zahrada/2018-thesis-drone/README.md

Construction of unmanned uerial vehicle for surveying jobs
 Department of Geomatics, FCE CTU in Prague, Czech Republic
