zahrada/2018-thesis-drone/text/1-reserse.tex

\chapter{Rešerše}
\label{1-reserse}

Bezpilotní letadla/drony jsou fenoménem dnešního stolení, zabývá se jimi spousta článku a projektů. Jsou zde uvedené projekty, které se zabývají stavbou dronu na platformě Arduino.\\

\textbf{Projekt YMFC-32}\\
%http://www.brokking.net/
%ymfc
Projekt popisuje stavbu dronu/quadrocoptéry ovládaného přes RC soupravu. Pro ovládání motorů na dronu byla použita platforma Arduino a periferie Arduina (IMU, Bluetooth).\\

\textbf{Univerzální software pro ovládání RC model;}\\
%http://www.multiwii.com/
%multiwii
Software je používán pro stavbu drona na platformě Arduino. Software obsahuje předdefinované různé typy dronů a Arduino periferíí.\\

\textbf{Projekt Arduino quadrocopter}\\
%http://mydronelab.com/blog/arduino-quadcopter.html
%mydronelab
Projekt se zabývá stavbou quadrokoptéry na platformě Arduino s využitím softwaru  Multiwii.\\

%https://www.geobusiness.cz/soutez-dronapp-2018/
