zahrada/2018-thesis-drone/diagrams/text/2-reserse.tex

\chapter{Rešerše}
\label{2-teorie}

Bezpilotní letadla/drony jsou fenoménem dnešní doby a zabývá se jimi spousta článků a projektů. Jsou zde uvedené projekty, které se zabývají stavbou dronu na platformě Arduino.\\

\textbf{Projekt YMFC-32}\\
%http://www.brokking.net/
Projekt popisuje stavbu dronu/quadrocoptéry ovládaného přes RC soupravu. Pro ovládání motorů na dronu byla použita platforma Arduino a periferie Arduina (IMU, Bluetooth). \cite{ymfc}\\

\textbf{Univerzální software pro ovládání RC modelů;}\\
%http://www.multiwii.com/
Software je používán pro stavbu drona na platformě Arduino. Software obsahuje předdefinované různé typy dronů a Arduino periferíí. \cite{multiwii}\\

\textbf{Projekt Arduino quadrocopter}\\
%http://mydronelab.com/blog/arduino-quadcopter.html
Projekt se zabývá stavbou quadrokoptéry na platformě Arduino s využitím softwaru  Multiwii. \cite{mydronelab}\\

%https://www.geobusiness.cz/soutez-dronapp-2018/
