zahrada/2018-thesis-drone/text/pictures/PWMDiagram.pdf

5V

0V

Signal

0uS

1000uS

2000uS

3000uS
4000uS

Time

HIGH

LOW

### PWM signal for ESC

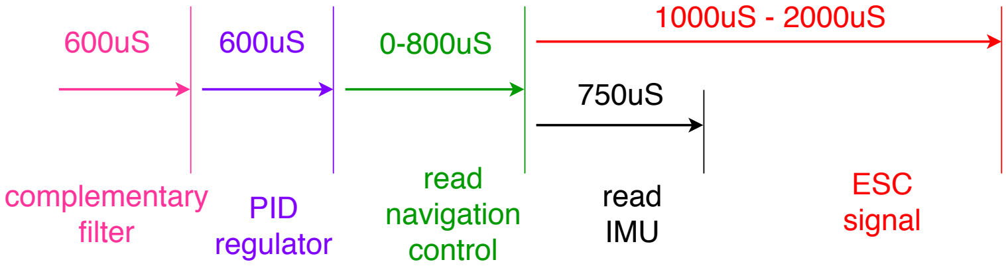
[picture p22: figure]
complementary filter; read navigation control; PID regulator; read IMU; ESC signal

Author: David Zahradník

frequency - 250Hz
