zahrada/2018-thesis-drone/diagrams/text/david-zahradnik-dp-2019.tex

%%%%%%%%%%%%%%%%%%%%%%%%%%%%%%%%%%%%%%%%%%%%%%%%%%%%%%%%%%%%%%%%%%%%%%%%%%%%%%%%%%%%%%%%%%%%%%%%%%%%%%%
%%													%%
%% 	DIPLOMOVÁ PRÁ			%%
%% 				 David Zahradník							%%
%%													%%
%% pro formátování využita šablona: http://geo3.fsv.cvut.cz/kurzy/mod/resource/view.php?id=775 	%%
%%													%%
%%%%%%%%%%%%%%%%%%%%%%%%%%%%%%%%%%%%%%%%%%%%%%%%%%%%%%%%%%%%%%%%%%%%%%%%%%%%%%%%%%%%%%%%%%%%%%%%%%%%%%% 

\documentclass[%
  12pt,         			% Velikost základního písma je 12 bodů
  a4paper,      			% Formát papíru je A4
  oneside,       			% Oboustranný tisk
  pdftex,				    % překlad bude proveden programem 'pdftex' do PDF
%%%  draft
]{report}       			% Dokument třídy 'zpráva'
%

\newcommand{\Fbox}[1]{\fbox{\strut#1}}

\usepackage[czech, english]{babel}	% použití češtiny, angličtiny
\usepackage[utf8]{inputenc}		% Kódování zdrojových souborů je UTF8

\usepackage[square,sort,comma,numbers]{natbib}

\usepackage{caption}
\usepackage{subcaption}
\captionsetup{font=small}
\usepackage{enumitem} 
\setlist{leftmargin=*} % bez odsazení

\makeatletter
\setlength{\@fptop}{0pt}
\setlength{\@fpbot}{0pt plus 1fil}
\makeatletter

\usepackage[dvips]{graphicx}   
\usepackage{color}
\usepackage{transparent}
\usepackage{wrapfig}
\usepackage{float} 

\usepackage{cmap}           
\usepackage[T1]{fontenc}    

\usepackage{textcomp}
\usepackage[compact]{titlesec}
\usepackage{amsmath}
\addtolength{\jot}{1em} 

\usepackage{chngcntr}
\counterwithout{footnote}{chapter}

\usepackage{acronym}

\usepackage[
    unicode,                
    breaklinks=true,        
    hypertexnames=false,
    colorlinks=true, % true for print version
    citecolor=black,
    filecolor=black,
    linkcolor=black,
    urlcolor=black
]{hyperref}         

\usepackage{url}
\usepackage{fancyhdr}
%\usepackage{algorithmic}
\usepackage{algorithm}
\usepackage{algcompatible}
\renewcommand{\ALG@name}{Pseudokód}% Update algorithm name
\def\ALG@name{Pseudokód}

\usepackage[
  cvutstyle,          
  diploma           
]{thesiscvut}

\newif\ifweb
\ifx\ifHtml\undefined % Mimo HTML.
    \webfalse
\else % V HTML.
    \webtrue
\fi 

\renewcommand{\figurename}{Obrázek}
\def\figurename{Obrázek}

%%%%%%%%%%%%%%%%%%%%%%%%%%%%%%%%%%%%%%%%%%%%%%%%%%%%%%%%%%%%%%%%%
%%%%%%%%%%% Definice informací o dokumentu  %%%%%%%%%%%%%%%%%%%%%
%%%%%%%%%%%%%%%%%%%%%%%%%%%%%%%%%%%%%%%%%%%%%%%%%%%%%%%%%%%%%%%%%

%% Název práce
\nazev{Konstrukce bezpilotního letadla pro \hyphenation{geodetické} práce}
{sdgfdg}

%% Jméno a příjmení autora
\autor{David}{Zahradník}

%% Jméno a příjmení vedoucího práce včetně titulů
\garant{Ing.~Zdeněk~Vyskočil,~Ph.D.}

%% Označení programu studia
\programstudia{Geodézie a~kartografie}{}

%% Označení oboru studia
\oborstudia{Geomatika}{}

%% Označení ústavu
\ustav{Katedra geomatiky}{}

%% Rok obhajoby
\rok{2019}

%Mesic obhajoby
\mesic{červen}

%% Místo obhajoby
\misto{Praha}

%% Abstrakt
\abstrakt {Tato diplomová práce se zabývá konstrukcí bezpilotního letadla pro geodetické účely na platformě Arduino s Arduino periferiemi.}  {This thesis describes construction of unmanned aerial vehicle for surveying jobs using Arduino platform and Arduino moduls.}

%% Klíčová slova
\klicovaslova
{bezpilotní letadlo, dron, Arduino, Android}
{UAV, dron, Arduino, Android}

%%%%%%%%%%%%%%%%%%%%%%%%%%%%%%%%%%%%%%%%%%%%%%%%%%%%%%%%%%%%%%%%%%%%%%%%

%%%%%%%%%%%%%%%%%%%%%%%%%%%%%%%%%%%%%%%%%%%%%%%%%%%%%%%%%%%%%%%%%%%%%%%%
%% Nastavení polí ve Vlastnostech dokumentu PDF
%%%%%%%%%%%%%%%%%%%%%%%%%%%%%%%%%%%%%%%%%%%%%%%%%%%%%%%%%%%%%%%%%%%%%%%%
\nastavenipdf
%%%%%%%%%%%%%%%%%%%%%%%%%%%%%%%%%%%%%%%%%%%%%%%%%%%%%%%%%%%%%%%%%%%%%%%

%%% Začátek dokumentu
\begin{document}

\catcode`\-=12  % pro vypnuti aktivniho znaku '-' pouzivaneho napr. v \cline 

% aktivace záhlaví
\zahlavi

% předefinování vzhledu záhlaví
\renewcommand{\chaptermark}[1]{%
	\markboth{\MakeUppercase
	{%
	\thechapter.%
	\ #1}}{}}

% Vysázení přebalu práce
%\vytvorobalku

% Vysázení titulní stránky práce
\vytvortitulku {}

% Vysázení listu zadani
\stranka{}%
	{
	}%\sffamily\Huge\centering\ }%ZDE VLOŽIT LIST ZADÁNÍ}%
	%{\sffamily\centering Z~důvodu správného číslování stránek}

% Vysázení stránky s abstraktem
\vytvorabstrakt

% Vysázení prohlaseni o samostatnosti
\vytvorprohlaseni

% Vysázení poděkování
\stranka{%nahore
       }{%uprostred
       }{%dole
       \sffamily
	\begin{flushleft}
		\large
		\MakeUppercase{Poděkování}
	\end{flushleft}
	\vspace{1em}
		%\noindent
	\par\hspace{2ex}
	{Chtěl bych poděkovat Ing. Zdeňkovi Vyskočilovi Ph.D. za pomoc a rady při zpracování diplomové práce. Dále bych rád poděkoval Lukášovi Černému za poskytnuté rady a vysvětlení témat týkajících se elektrotechniky.}
}

% Vysázení obsahu
\obsah

% Vysázení seznamu obrázků
\seznamobrazku

% Vysázení seznamu tabulek
\seznamtabulek

% jednotlivé kapitoly
\include{0-uvod}
\include{2-reserse}
\include{2-teorie}
\include{3-soucastky}
%\include{4-stavba}
\include{5-algoritmus}
\include{6-testovani}
\include{7-aplikace}
\include{8-zaver}

% Vysázení seznamu zkratek
\include{zkratky}

% Literatura
\nocite{*}
\def\refname{Literatura}
\bibliographystyle{mystyle}
\bibliography{literatura}

% Začátek příloh
\def\figurename{Figure}%
\prilohy

% Vysázení seznamu příloh
%\seznampriloh

% Vložení souboru s přílohami
\include{prilohy}

% Konec dokumentu
\end{document}
