zahrada/2018-thesis-drone/text/pictures/navictrl.pdf

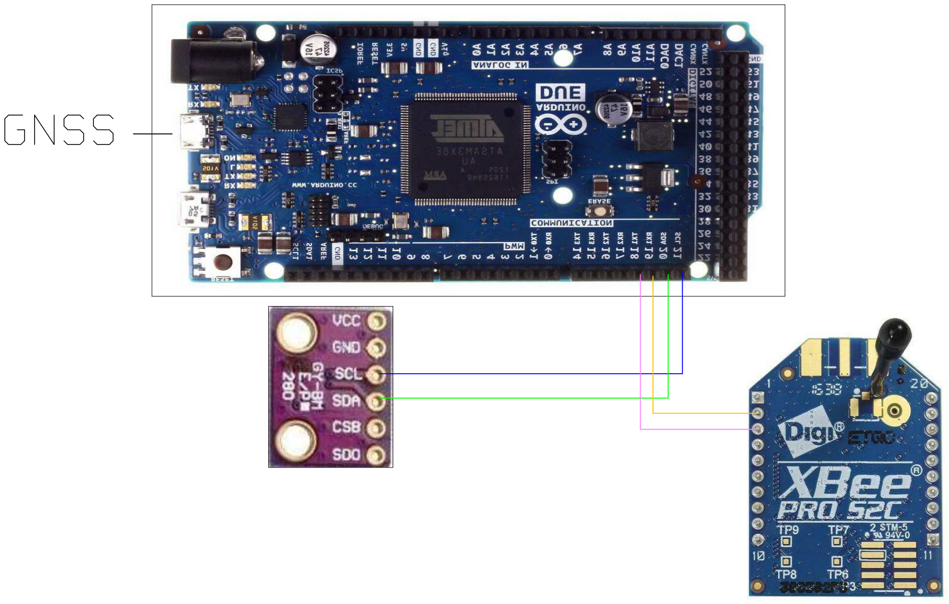
[picture p23: page 1]
