zahrada/2018-thesis-drone/diagrams/text/pictures/flyctrl.pdf

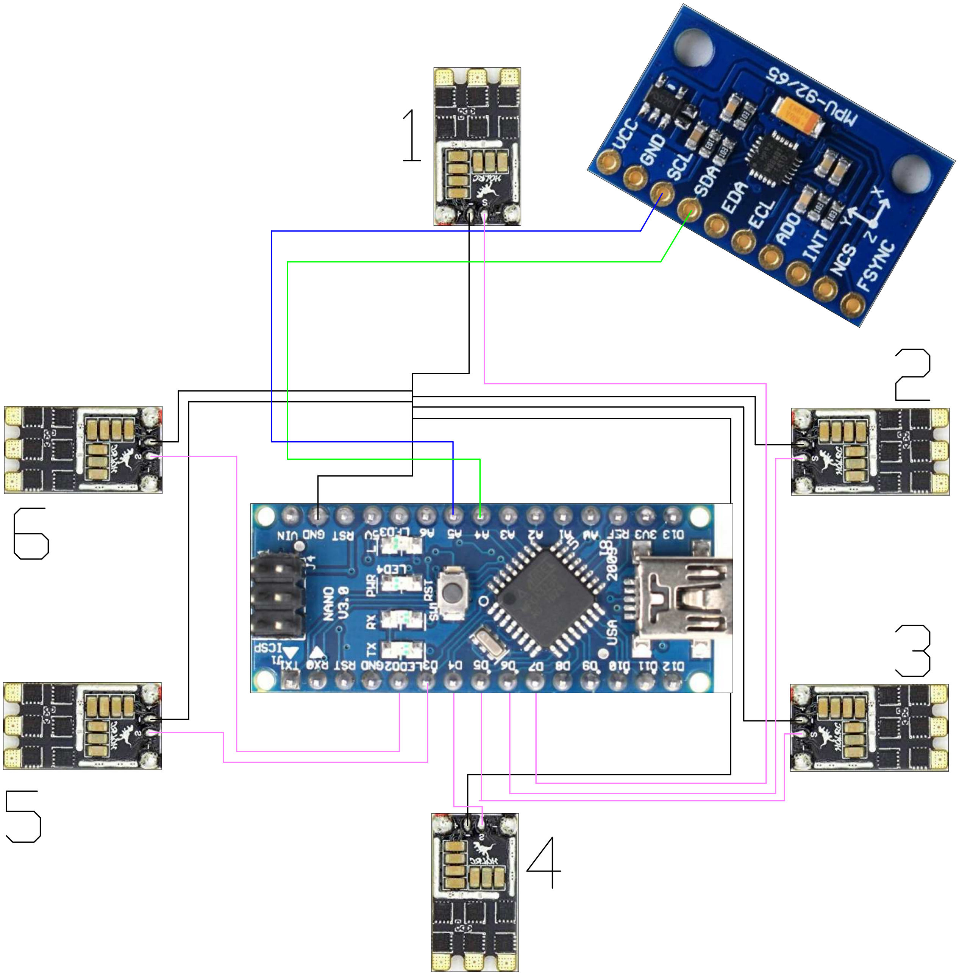
[picture p24: figure]
