zahrada/2018-thesis-drone/diagrams/text/pictures/obstacle.pdf

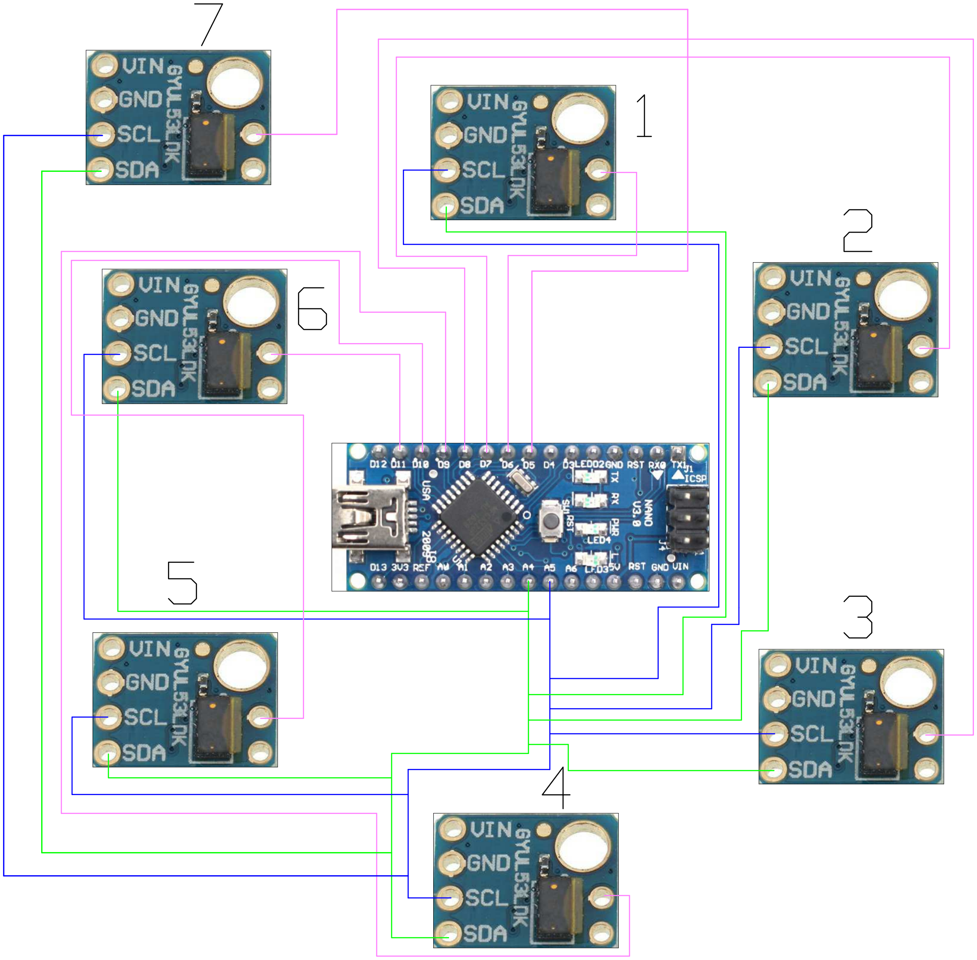
[picture p25: figure]
