zahrada/2018-thesis-drone/diagrams/text/pictures/pdb_ardu.pdf

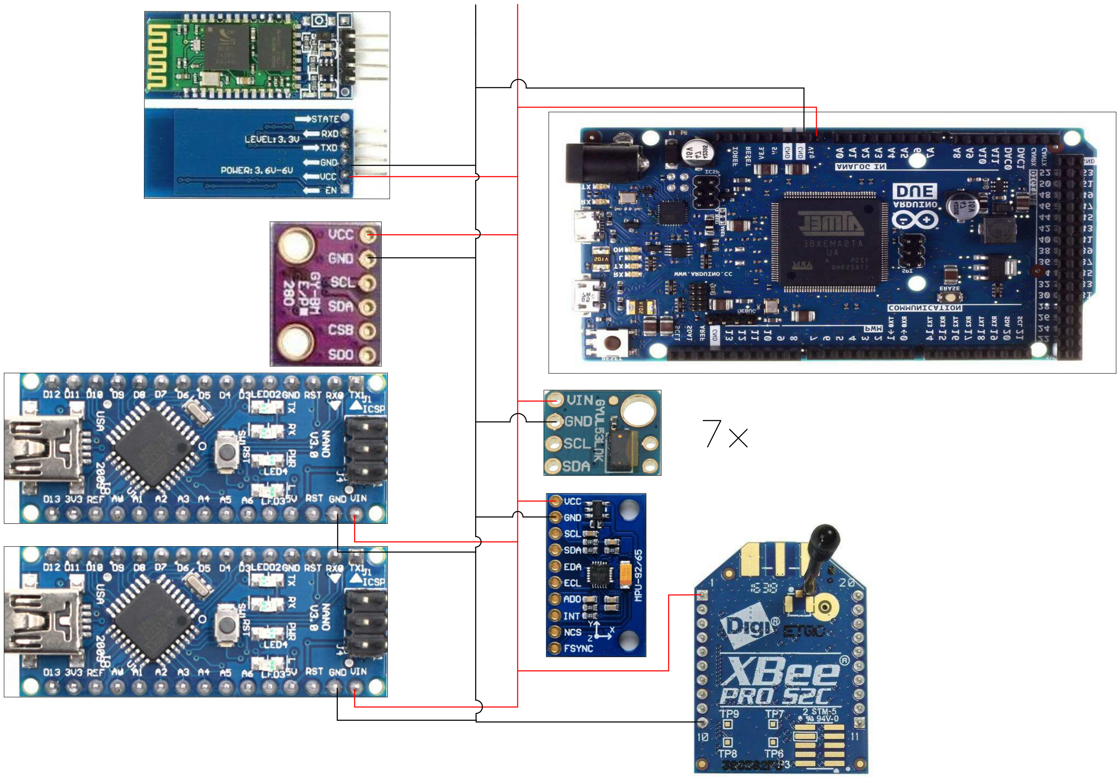
[picture p26: page 1]
