zahrada/2018-thesis-drone/diagrams/text/pictures/zadani.pdf

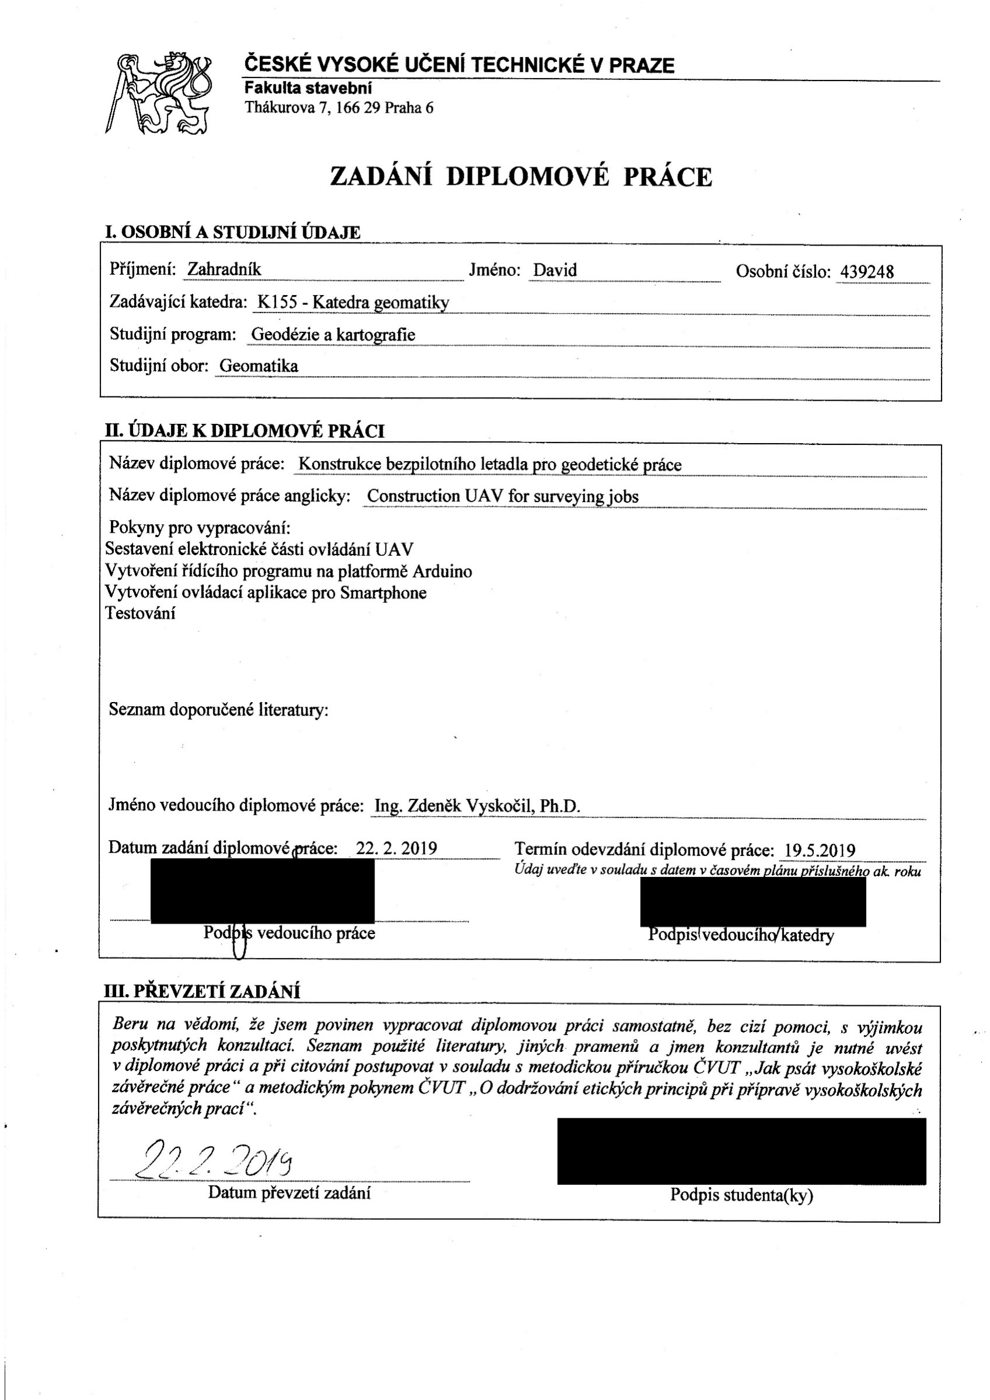
[picture p27: page 1]
