zahrada/2018-thesis-drone/diagrams/text/pictures/esc_calib.pdf

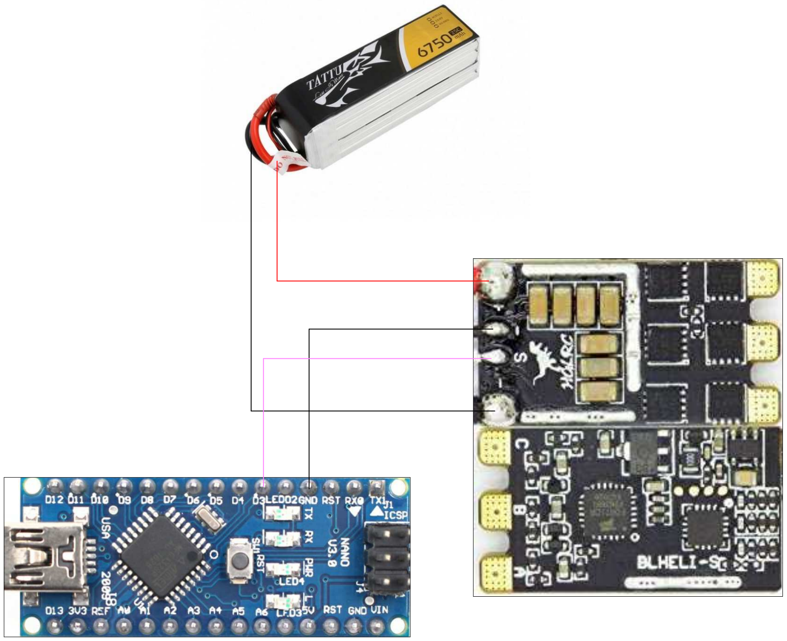
[picture p28: page 1]
