zahrada/2018-thesis-drone/diagrams/text/pictures/motor.pdf

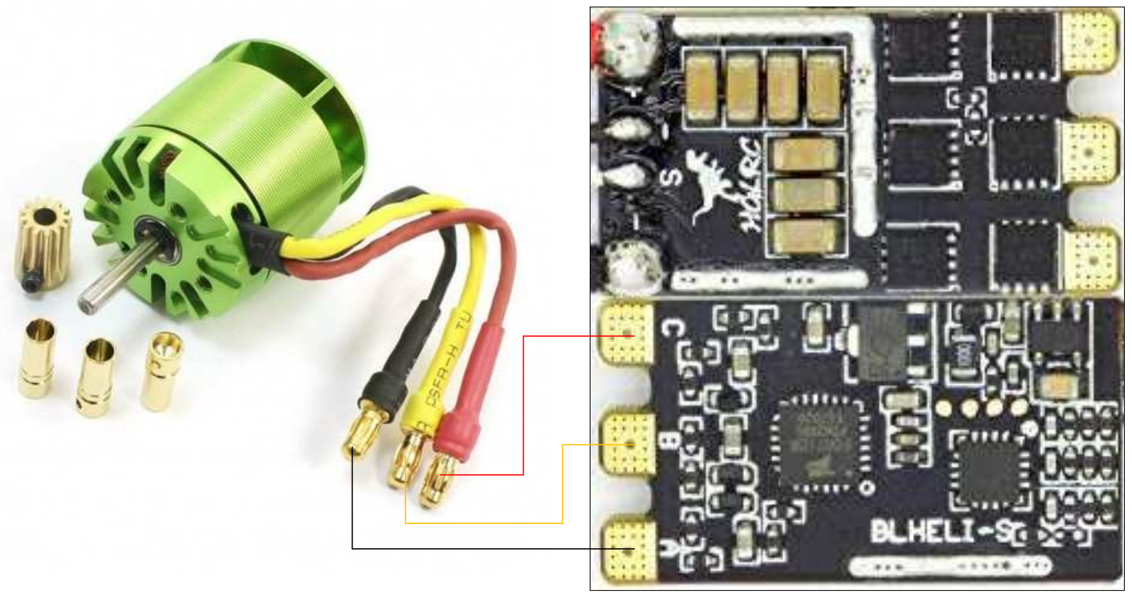
[picture p29: page 1]
