zahrada/2018-thesis-drone/diagrams/text/pictures/esc_calib1.jpg

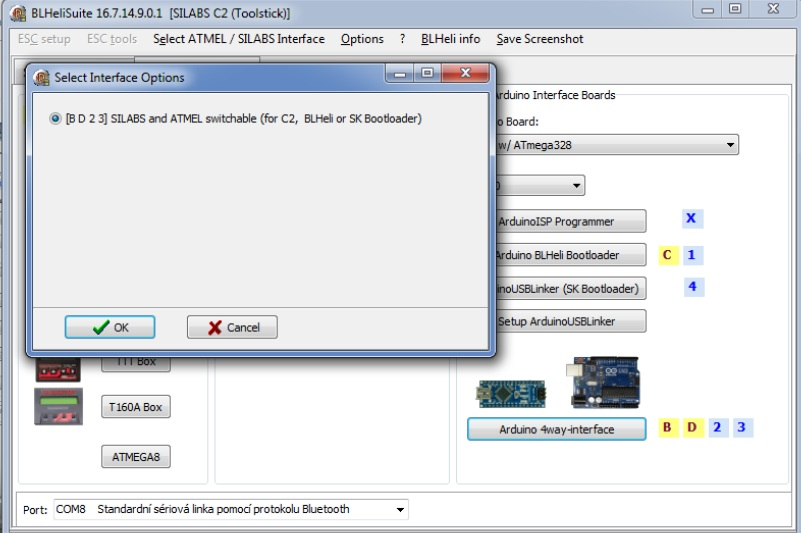
diagrams/text/pictures/esc_calib1.jpg
