zahrada/2018-thesis-drone/diagrams/text/pictures/esc_calib3.jpg

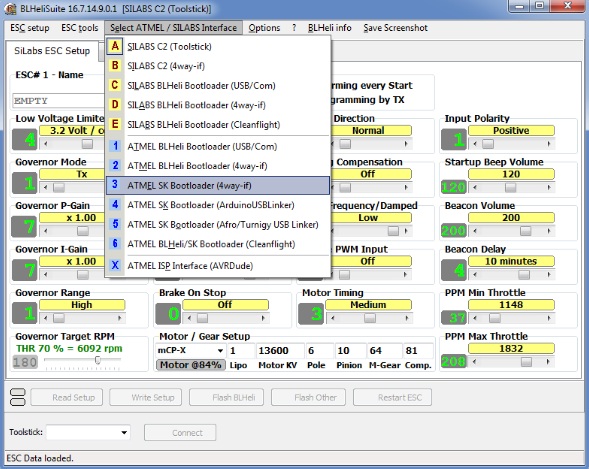
diagrams/text/pictures/esc_calib3.jpg
