zahrada/2018-thesis-drone/diagrams/text/pictures/zadani.jpg

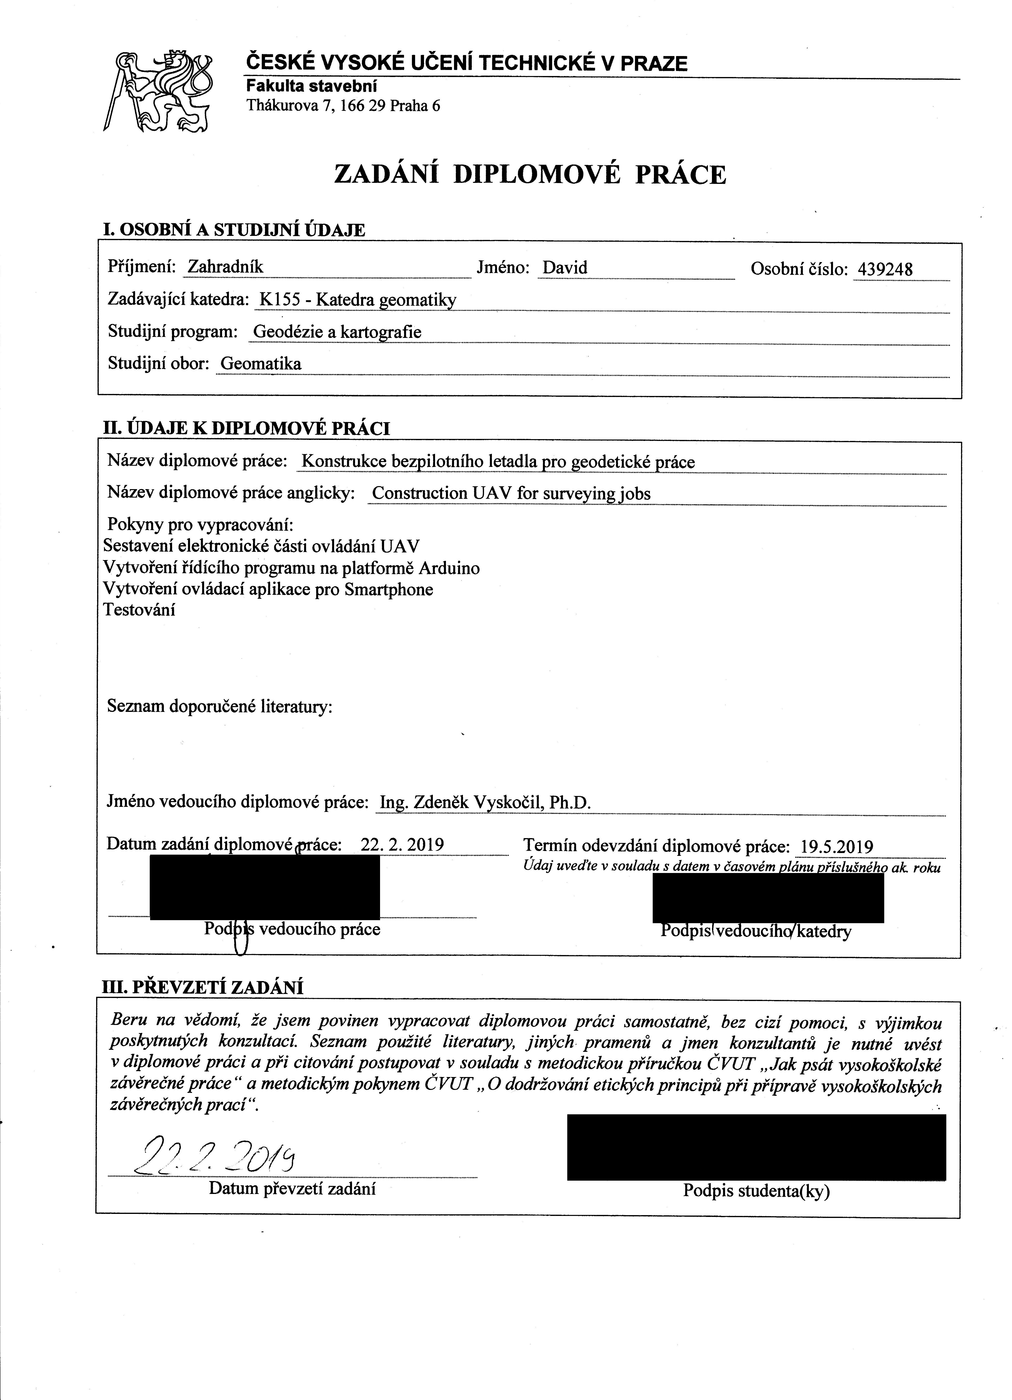
diagrams/text/pictures/zadani.jpg
