zahrada/2018-thesis-drone/testingIMU/results.txt

eps = 0.00000001;

data_2018_11_16_9_07.m
Start from 2260
Heading is 113.186980 0.433416
Pitch is -0.729511 0.014578
Roll is 0.638921 0.003028
North is 311.623718 46.927729
>> 

data_2018_11_16_9_26.m
Start from 2267
Heading is 112.851388 0.051998
Pitch is -0.667009 0.013853
Roll is 0.688009 0.002768
North is 316.273513 47.825867
>> 

data_2018_11_16_9_44.m
Start from 1574
Heading is 113.821797 0.158678
Pitch is -0.819365 0.014549
Roll is 0.665427 0.003013
North is 309.473818 40.155538

data_2018_11_16_9_54.m
Start from 1290
Heading is 114.127414 0.730425
Pitch is -0.806325 0.020755
Roll is 0.650201 0.003610
North is 309.518649 55.124147
>> 

data_2018_11_16_10_15.m
Start from 1406
Heading is 113.195257 0.356729
Pitch is -0.738615 0.015786
Roll is 0.705472 0.003096
North is 314.087512 47.828897
>> 

eps = 0.0000000001;

data_2018_11_16_10_15.m
Start from 2815
Heading is 112.995883 0.039574
Pitch is -0.716273 0.012963
Roll is 0.713163 0.002643
North is 315.215289 41.817757
