zahrada/2018-thesis-drone/diagrams/text/pictures/testAGC.png

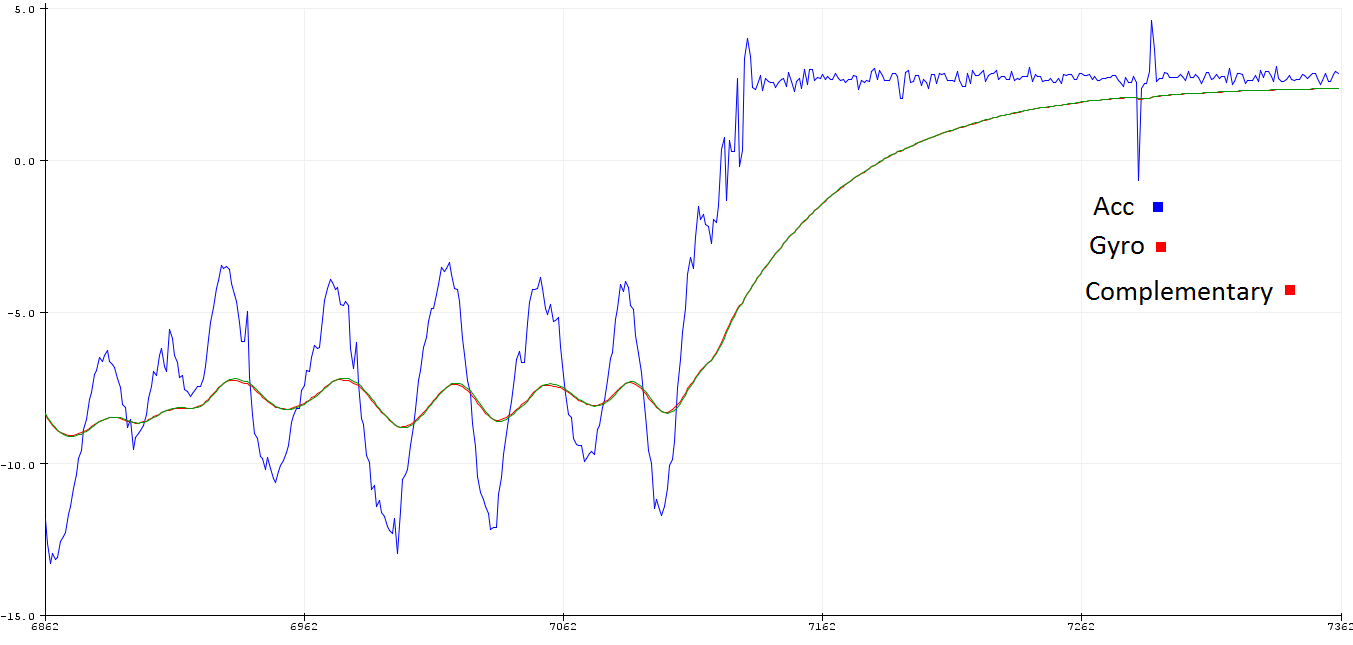
diagrams/text/pictures/testAGC.png
