zahrada/2018-thesis-drone/diagrams/text/pictures/testGMC.png

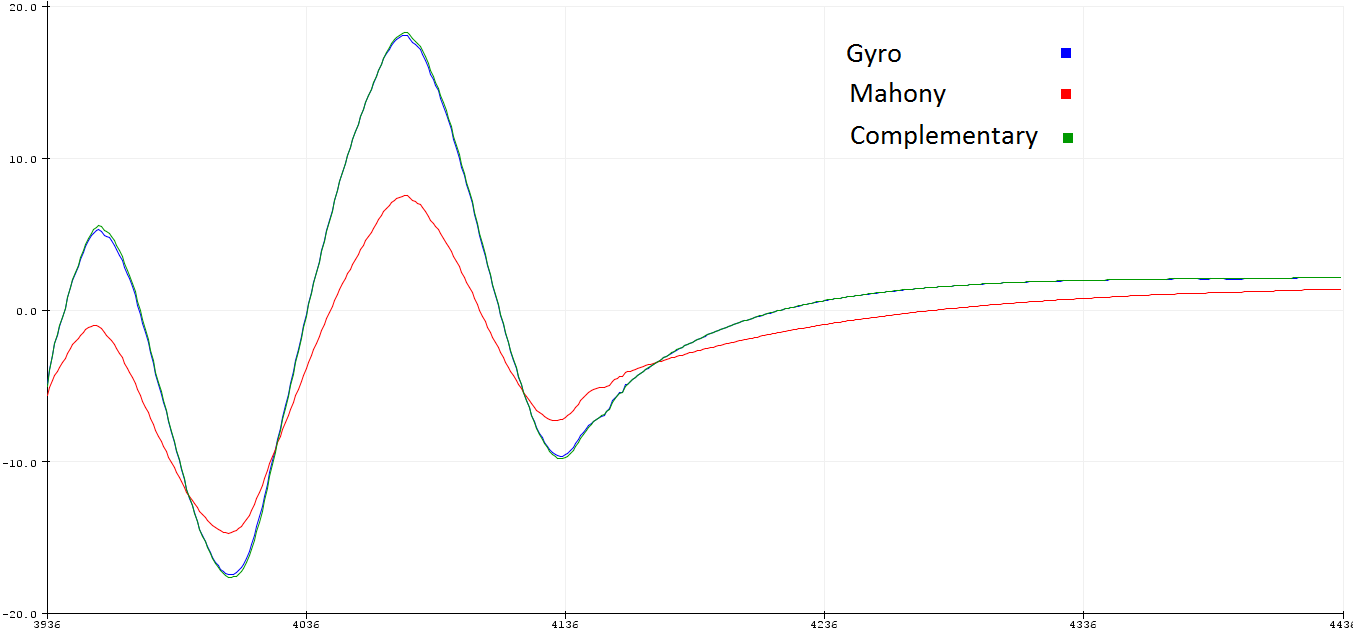
diagrams/text/pictures/testGMC.png
