zahrada/2018-thesis-drone/diagrams/text/pictures/testIMUACC.png

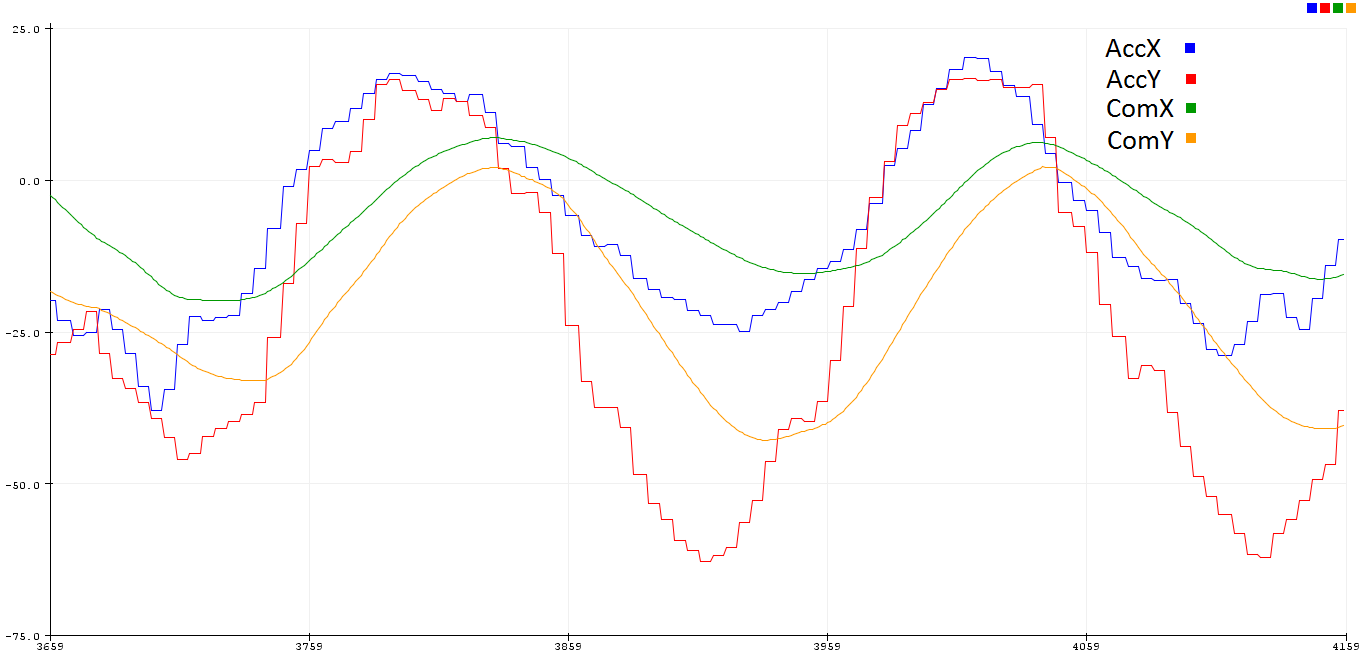
diagrams/text/pictures/testIMUACC.png
