zahrada/2018-thesis-drone/testingIMU/graf.tif

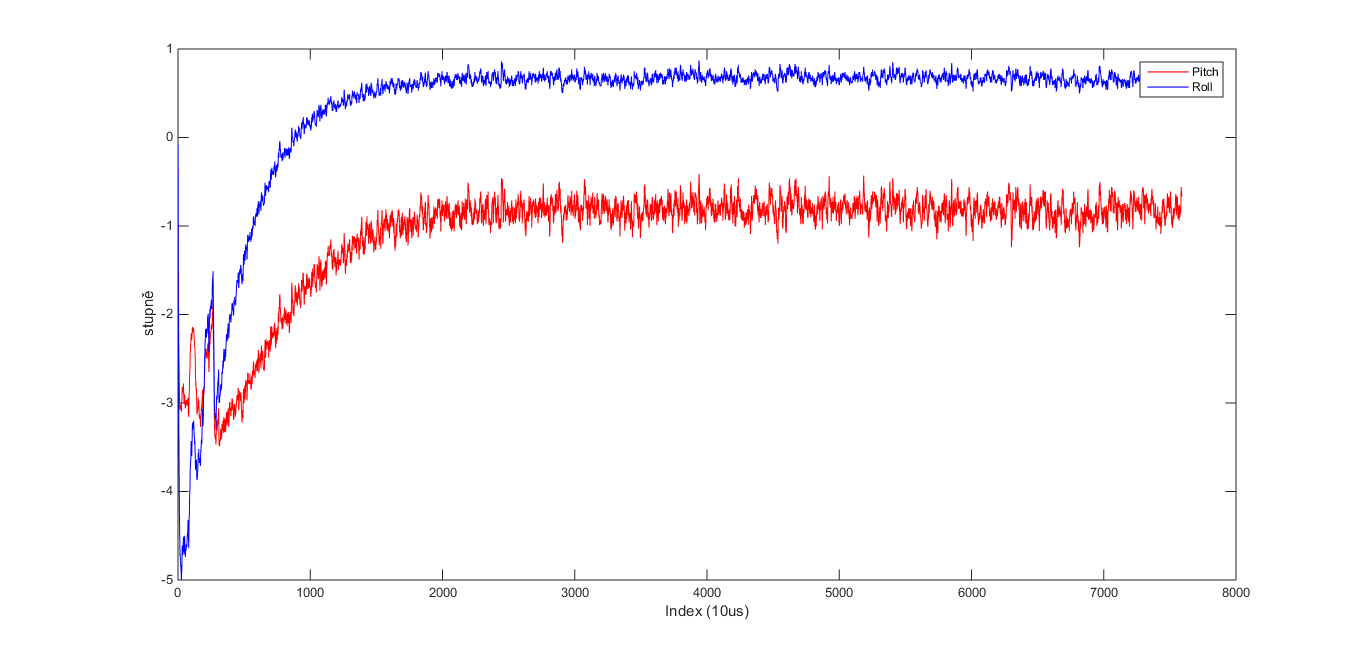
testingIMU/graf.tif
