zahrada/2018-thesis-drone/diagrams/text/pictures/DroneDiagram.pdf

## Diagram of connection

## Controler

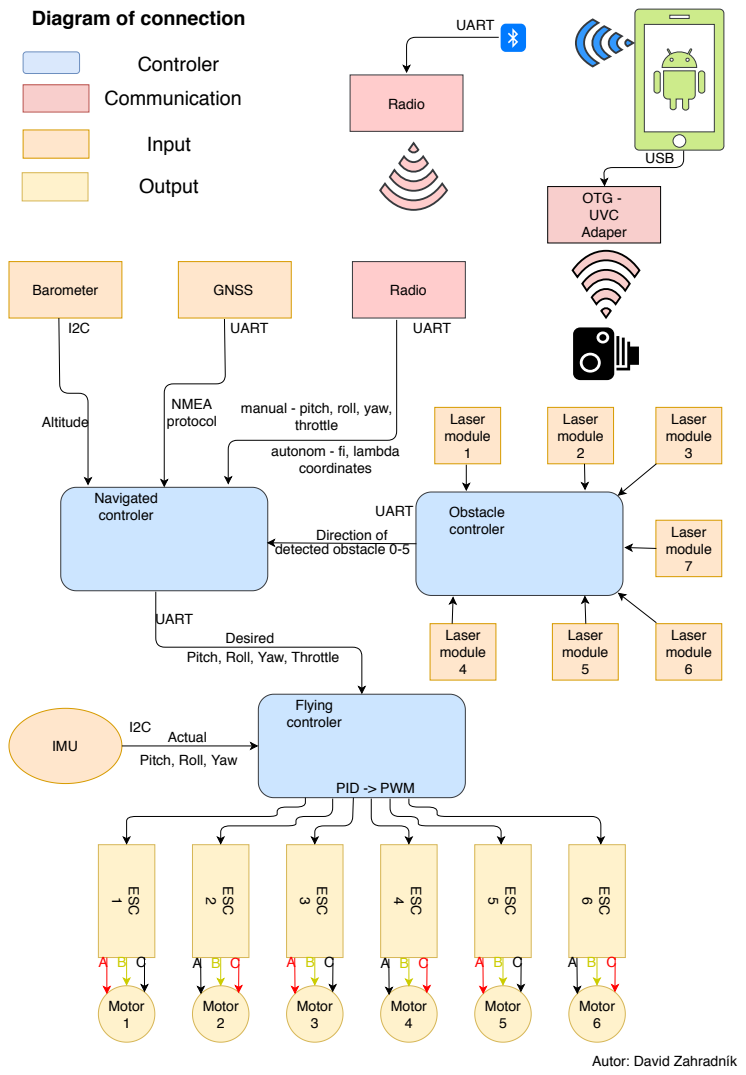
[picture p42: page 1]
Navigated controler; Motor 1; Motor 2; Motor 3; Motor 4; Motor 5; Motor 6; ESC; PID -> PWM; IMU; Pitch, Roll, Yaw; Actual; Flying controler; Obstacle controler; Laser module 5; Laser module 1; Laser module 2; Laser module 3; Laser module 7; Laser module 6; Laser module 4; UART; Direction of detected obstacle 0-5; Barometer; GNSS; Radio; Altitude; NMEA protocol; OTG - UVC Adaper; USB; Communication; Input; Output

manual - pitch, roll, yaw,

throttle
autonom - fi, lambda
coordinates

Desired
Pitch, Roll, Yaw, Throttle

Autor: David Zahradník
