zahrada/2018-thesis-drone/diagrams/text/pictures/FlyingDiagram.pdf

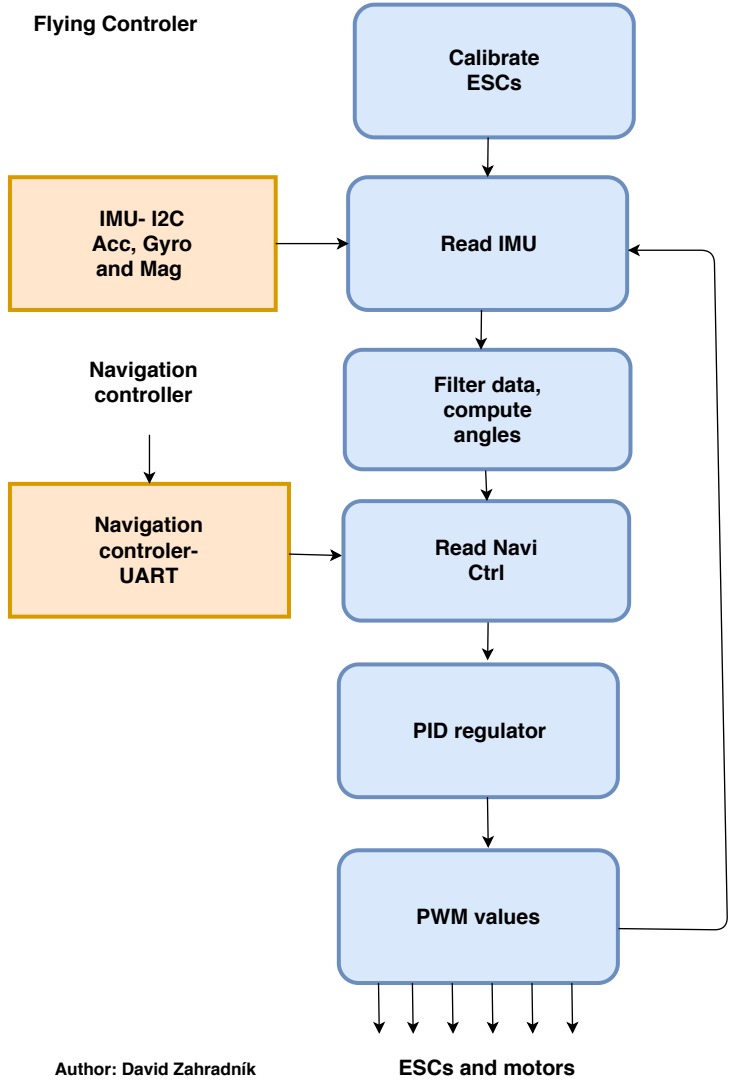
[picture p43: page 1]
Flying Controler; Navigation controler- UART; IMU- I2C Acc, Gyro and Mag; Read IMU; Filter data, compute angles; PID regulator; PWM values; Calibrate ESCs; Read Navi Ctrl; Navigation controller

Author: David Zahradník

ESCs and motors
