zahrada/2018-thesis-drone/diagrams/text/pictures/NaviDiagram.pdf

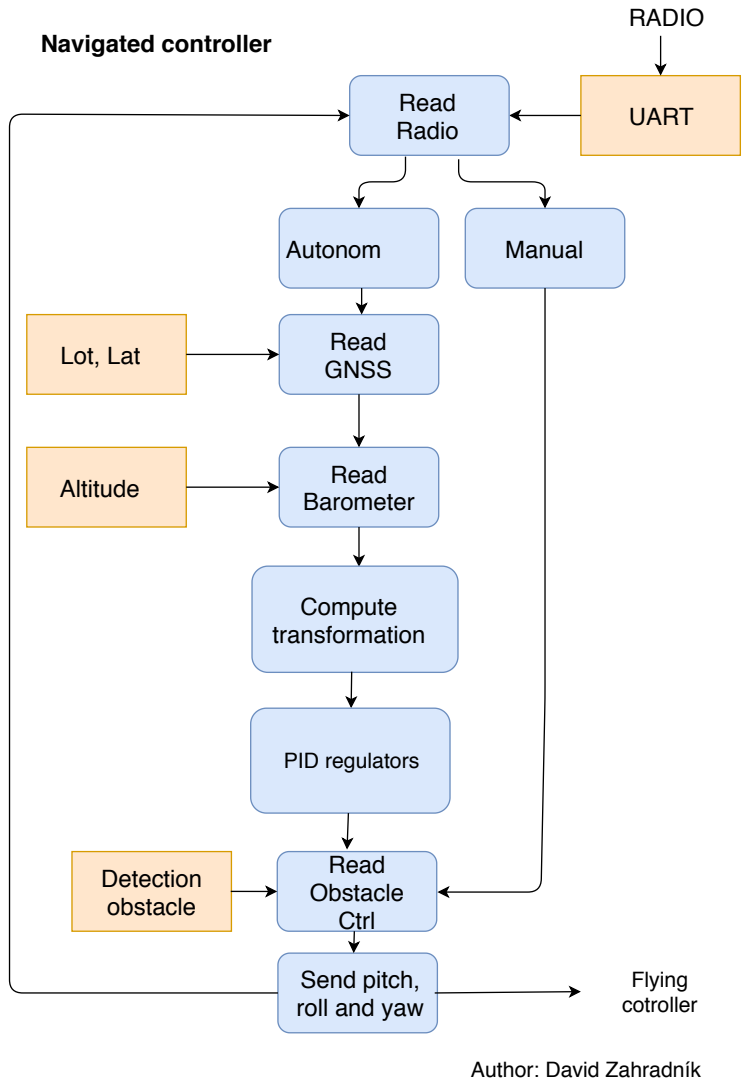
[picture p44: page 1]
Navigated controller; UART; Lot, Lat; Altitude; Read GNSS; Read Barometer; Detection obstacle; Read Obstacle Ctrl; RADIO; Compute transformation; PID regulators; Flying cotroller; Autonom; Manual; Read Radio

Send pitch,
roll and yaw

Author: David Zahradník
