zahrada/2018-thesis-drone/diagrams/text/pictures/ObstacleDiagram.pdf

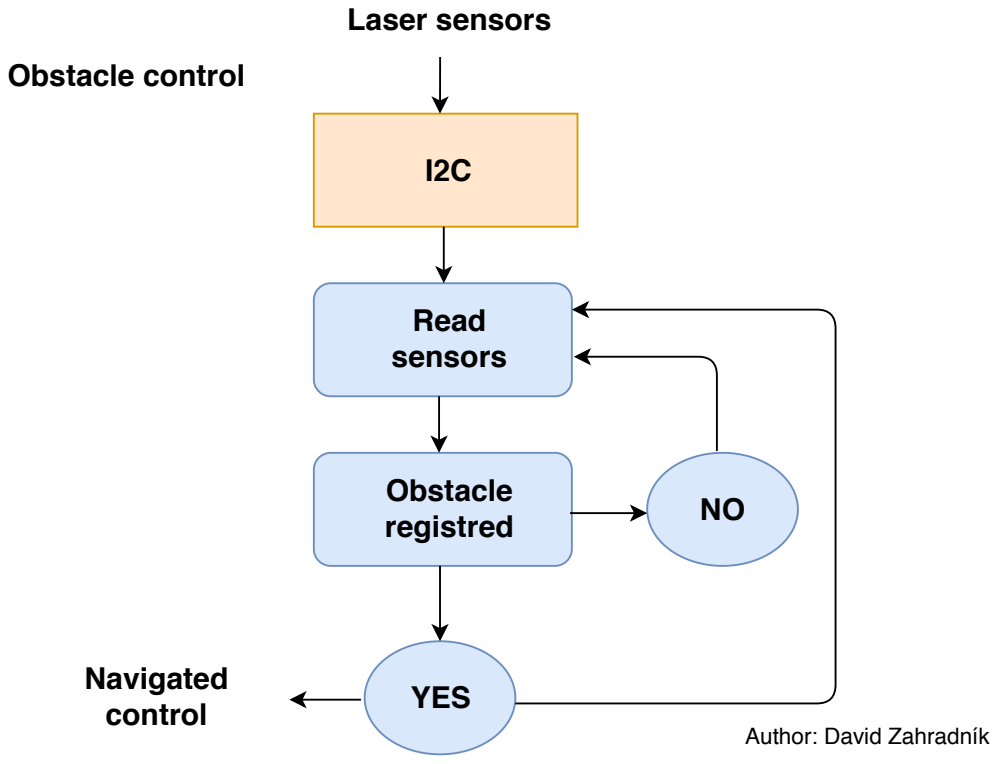
[picture p45: page 1]
Obstacle control; Read sensors; Obstacle; registred; YES; Laser sensors; Navigated control

Author: David Zahradník
