zahrada/2018-thesis-drone/diagrams/text/pictures/PIDDiagram.pdf

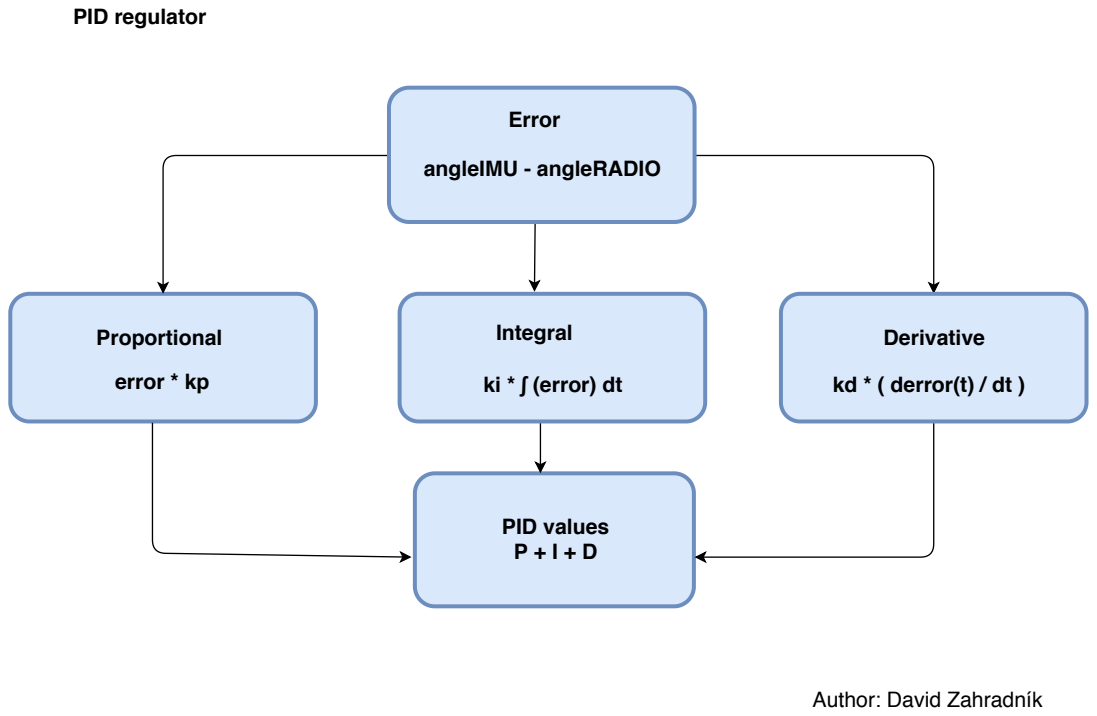
[picture p46: page 1]
Proportional; PID values P + I + D; Integral; Derivative; Error; angleIMU - angleRADIO; error * kp; ki * ∫ (error) dt; kd * ( derror(t) / dt ); PID regulator

Author: David Zahradník
