zahrada/2018-thesis-drone/diagrams/text/pictures/PIDsDiagram.pdf

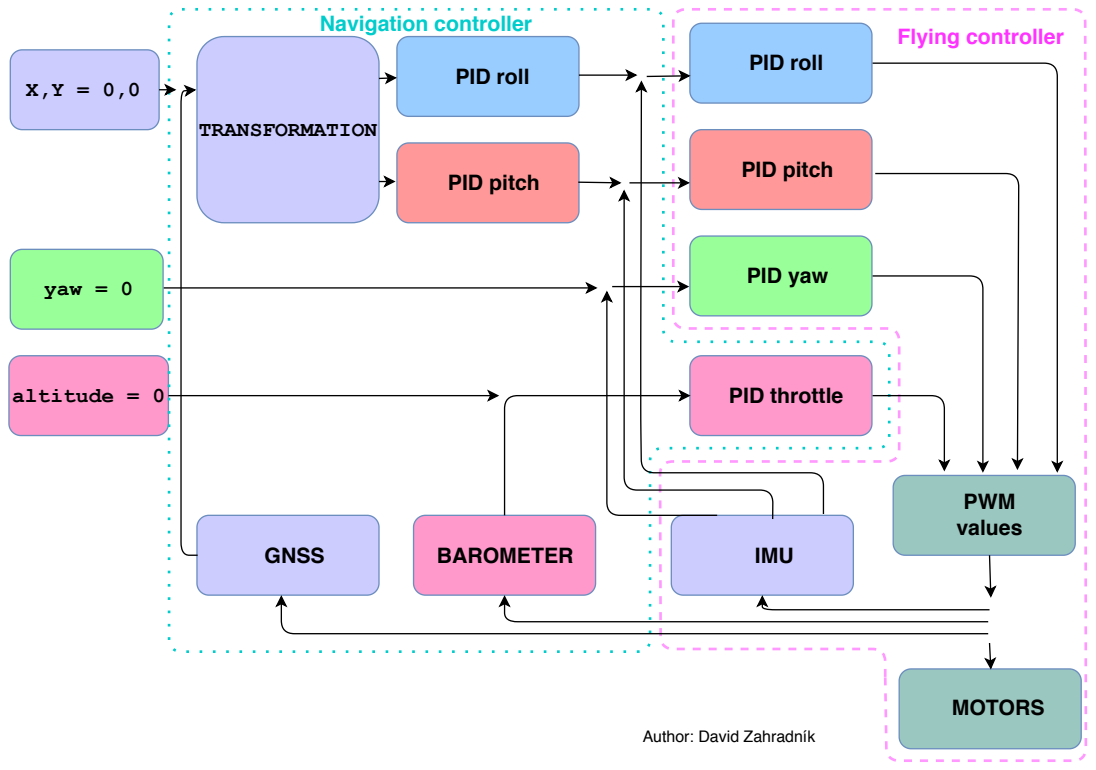
[picture p47: page 1]
MOTORS; PWM values; PID roll; PID pitch; PID yaw; PID throttle; GNSS; BAROMETER; IMU; TRANSFORMATION; yaw = 0; altitude = 0; Navigation controller; Flying controller

Author: David Zahradník
