zahrada/2018-thesis-drone/diagrams/text/pictures/rcDiagram.pdf

## RC reciever

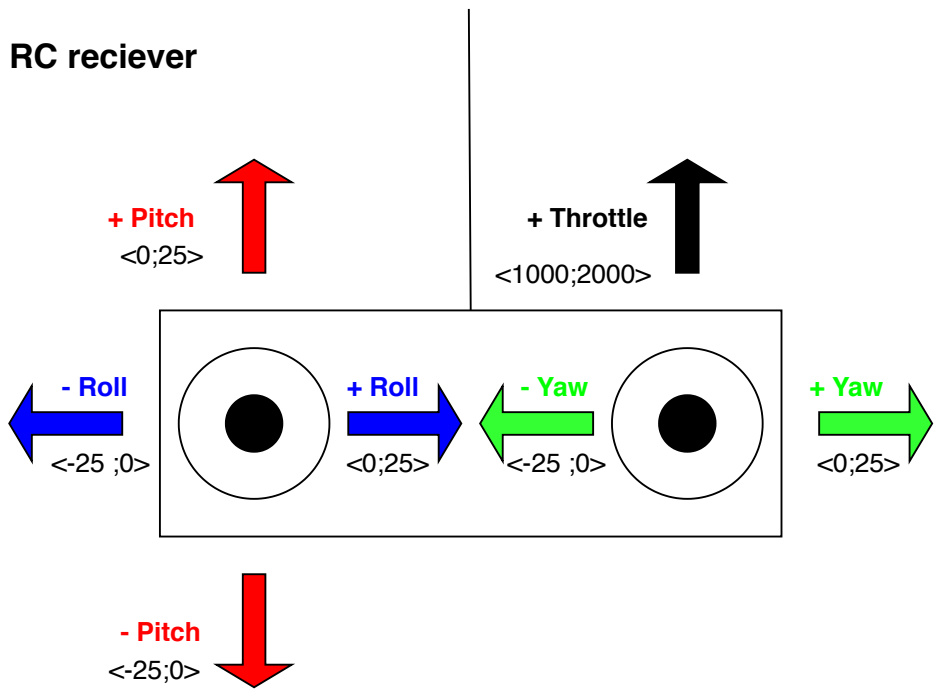
[picture p48: page 1]
+ Pitch; - Pitch; - Roll; + Roll; + Throttle; - Yaw; + Yaw
