zahrada/2018-thesis-drone/diagrams/text/pictures/obstacle_teo.pdf

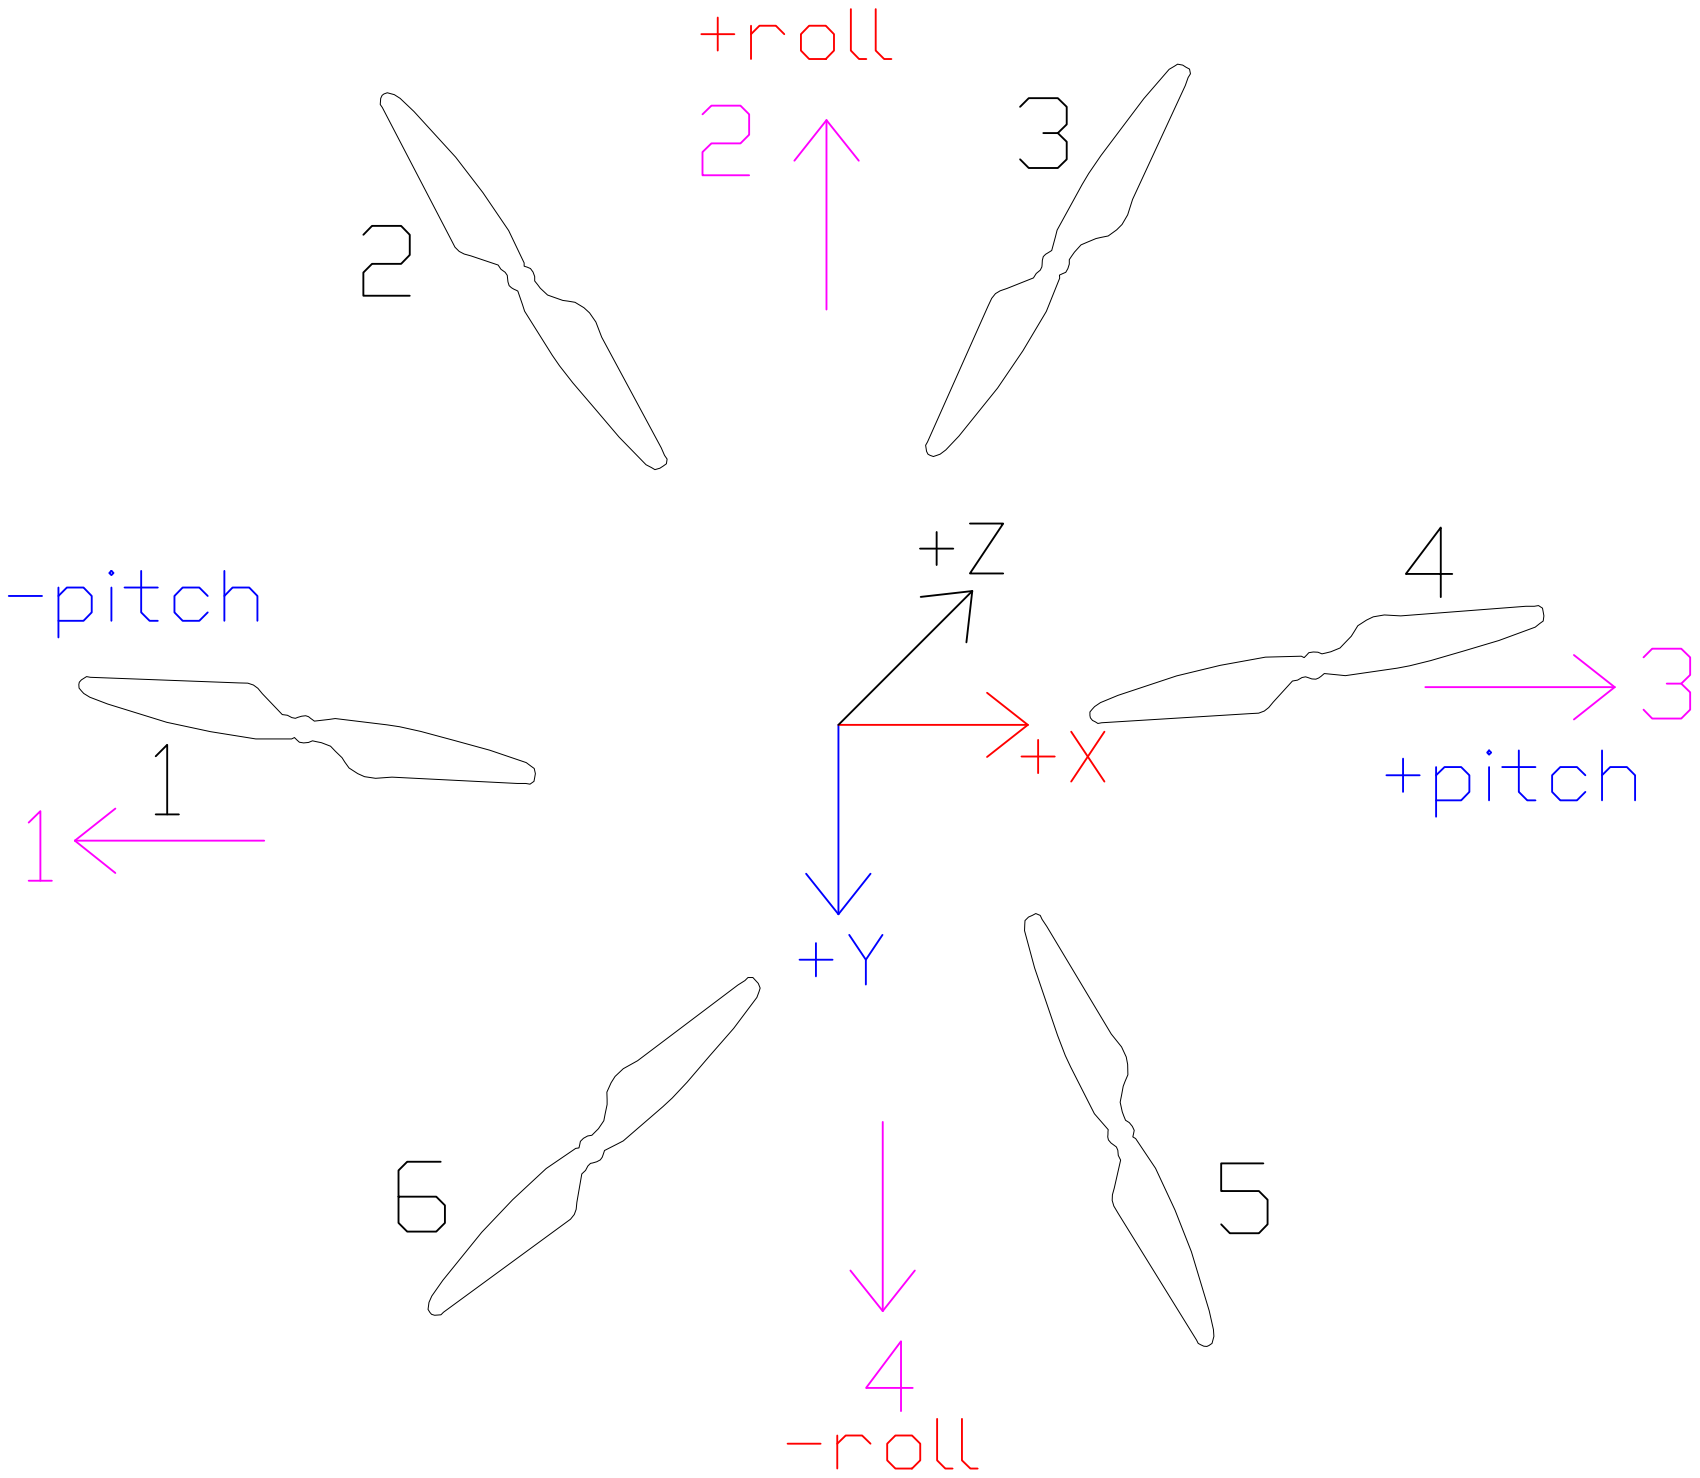
[picture p49: page 1]
