zahrada/2018-thesis-drone/diagrams/text/pictures/pdb_com.pdf

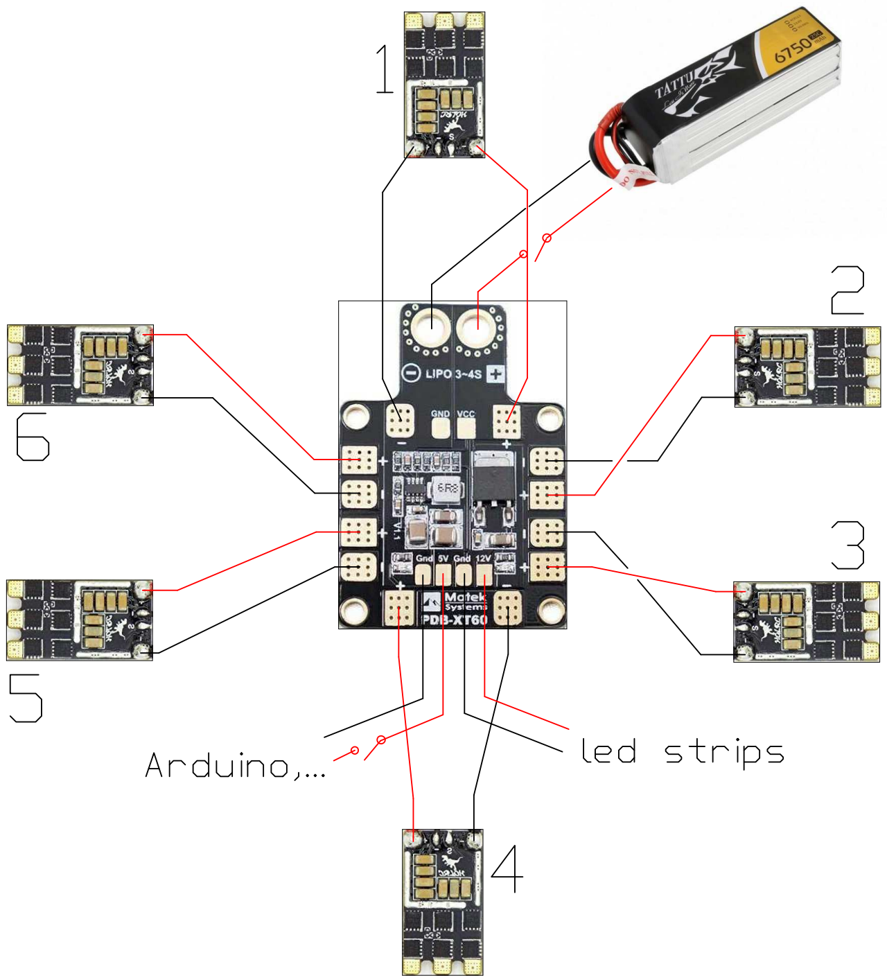
[picture p50: page 1]
