zahrada/2018-thesis-drone/diagrams/text/pictures/pid.pdf

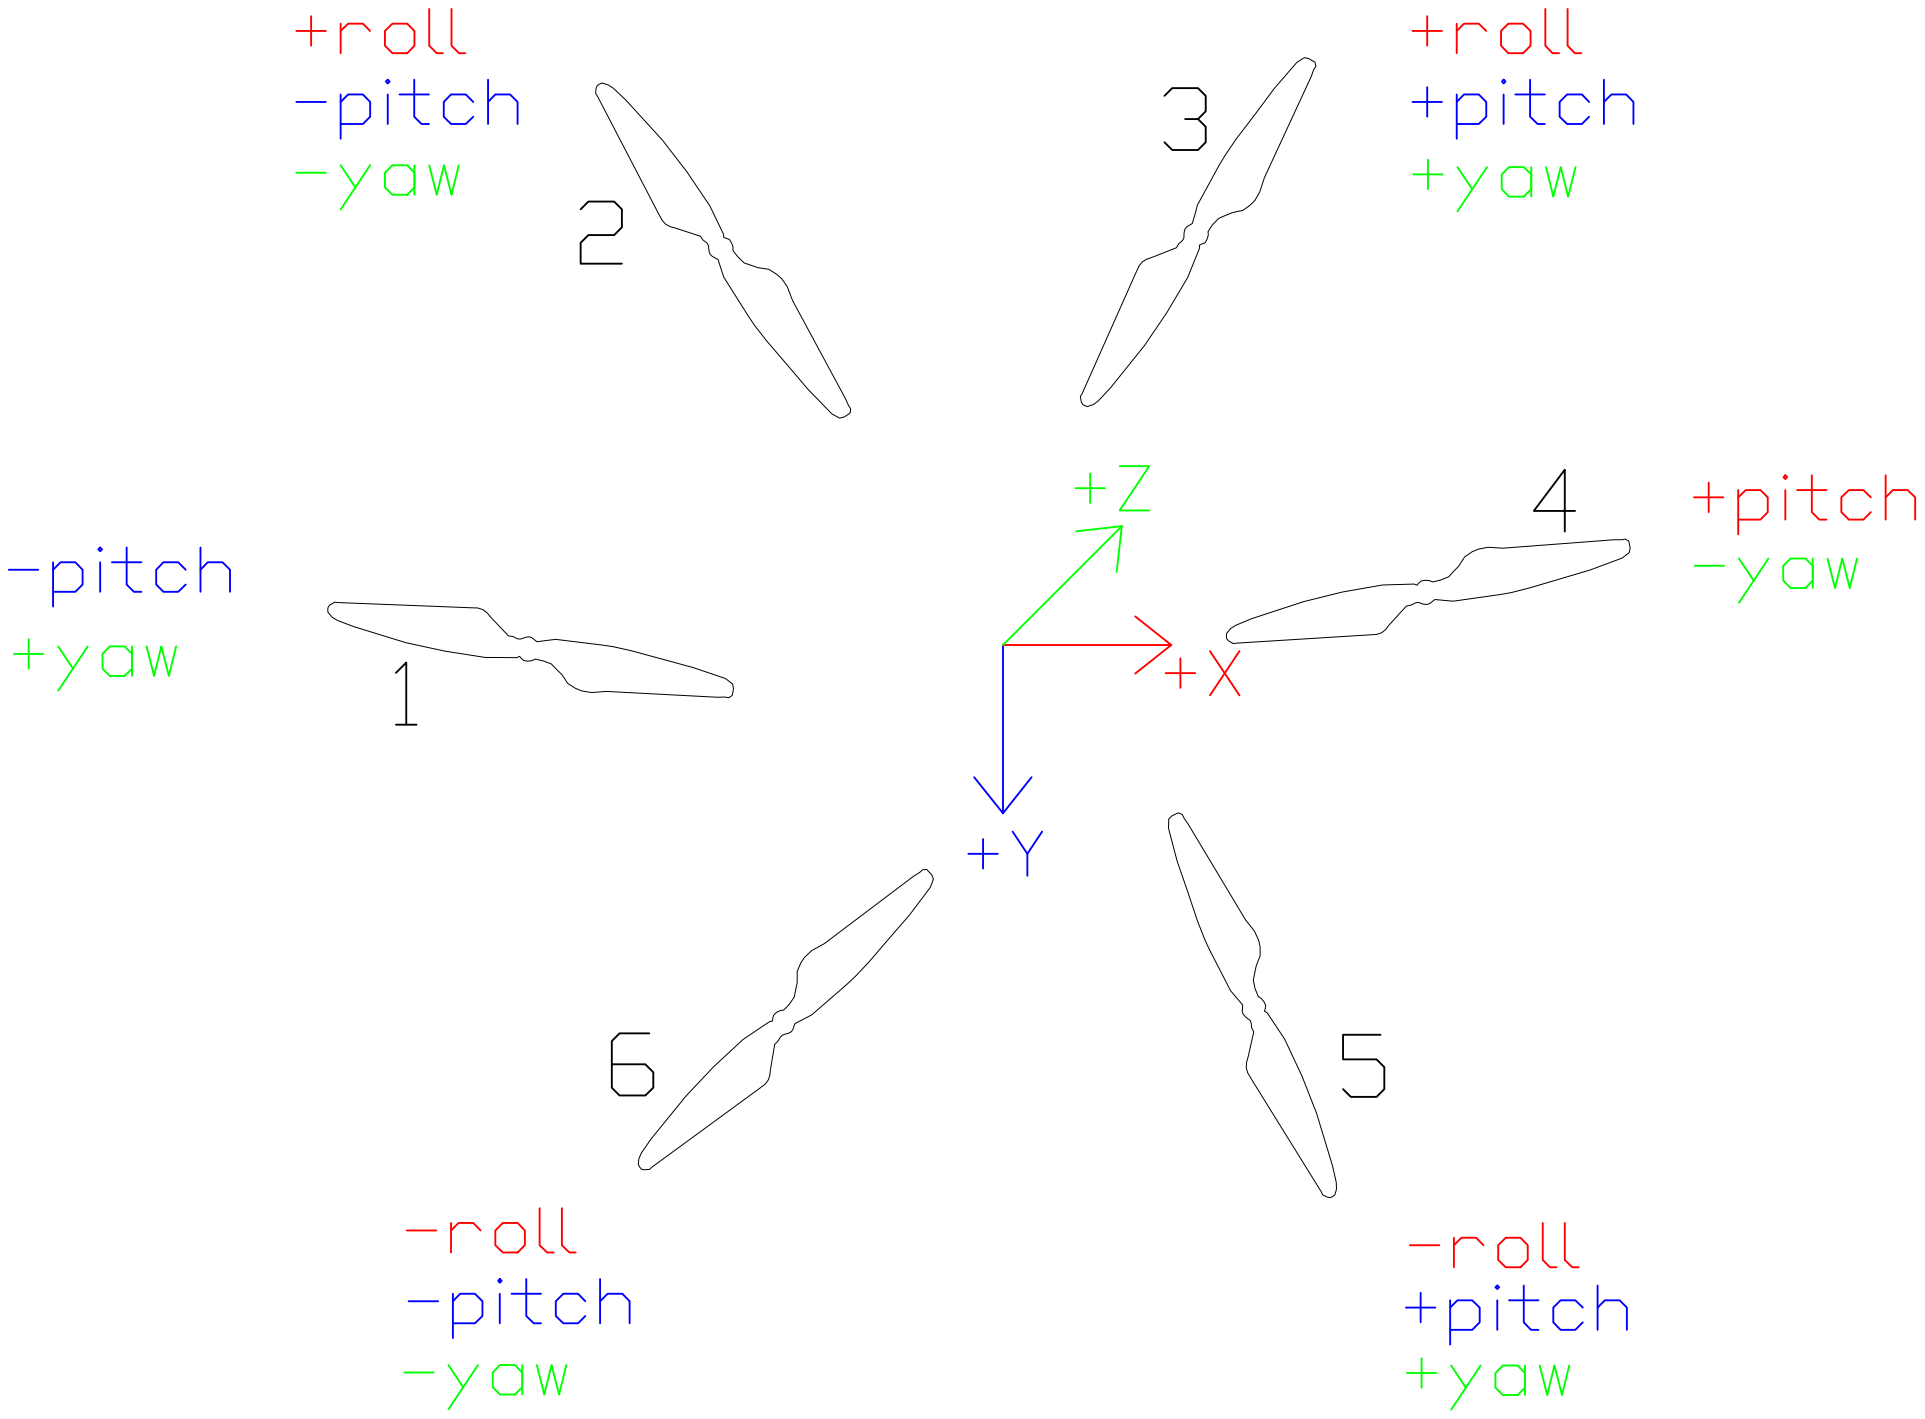
[picture p51: page 1]
