zahrada/2018-thesis-drone/(commit log)

2019-05-12 text, fly-ctrl servo problem
    [drone_belheli.ino, fly_ctrl.ino, navi_ctrl.ino, obstacle_sensor.ino, ovladac.ino]
2019-05-19 text, PWMDiagram, flyctrl
